eSpark-Backup/shuran-biotrackingdevice-hw/docs/Client-Files/PRD/Components list V1.2 05102024.xlsx

No. | Item | Part number/Model | Manufacturer | Note
1 | MCU | NRF5340-QKAA-R | Nordic
2 | LTE | SIM7500A | SIMCOM | North America region
3 | Bio tracking | MAX86176ENX+T | Maxim
 |  | MAX32666GXMBT+
 |  | MAX32674CGWGZ+
4 | LTE Antenna | IPEX Wired Antenna |  | define later
5 | GNSS Antenna | IPEX Wired Antenna |  | define later
6 | BLE Antenna | ANT3216LL00R2400A | Pulse Electronics
7 | Motion tracking | BMI270 | Bosch
8 | Microphone | ICS-40618 | TDK InvenSense | MEMS MIC
9 | Audio Codec | NAU8810YG | Nuvoton Tech | can replace due to space constraint
10 | Skin temperature sensor | AS6221-AWLT-S | AMS-OSRAM AG
11 | Speaker |  |  | define later
12 | Battery monitor | MAX17048G+T10 or LC709204FXE-01TBG | Analog Devices Inc./Maxim Integrated | can replace due to space constraint
13 | Battery charger | BQ24074RGTR | Texas Instruments
14 | Boost to 5V for PD LED | TPS61256AYFFR or MAX17270ENE+T | Texas Instruments | can replace due to space constraint
15 | LDO 3.3V | TPS7A0233PDQNR or MAX17270ENE+T | Texas Instruments | can replace due to space constraint
16 | LDO 1.8V | TPS7A0218PDQNR or MAX17270ENE+T | Texas Instruments | can replace due to space constraint
17 | Boost to 4.3V for LTE | MT3608L | XI'AN Aerosemi Tech | can replace due to space constraint
18 | Loadswitch | TCK107AG,LF or SIP32458DB-T2-GE1 |  | define later for fit space constraint
19 | Button | PTS830GG140SMTRLFS | ITT C&K
20 | RGB LED | XL-1615RGBC-RF | XINGLIGHT
21 | Charing port | Spring-Loaded Magnetic Pogo pin | China | define later
22 | Battery | 30x35x8mm 800mAh | China | can replace due to space constraint
23 | SWD jig pad | Custom jig pad 1.27mm pitch | N/A
