eSpark-Backup/shuran-biotrackingdevice-hw/Design-Files/Bio-Tracking-Device/Schematic/Bio-Tracking-Device.pdf

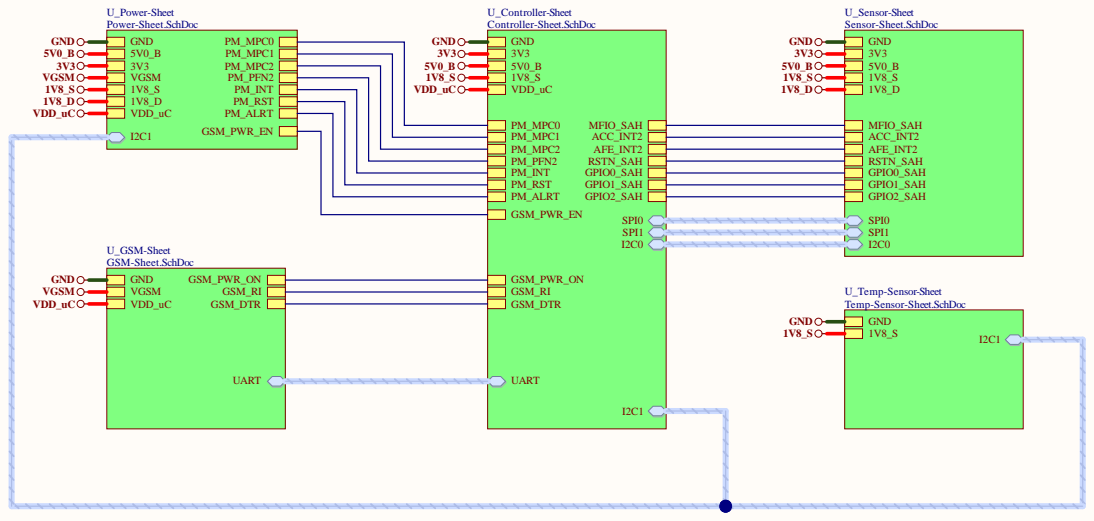
[picture p8: page 1]

Bio-Tracking-Device.PrjPcb

Date: 12/10/2024 | Page Num: 1

Drawn By: Huzaifa Ali | Page Total:

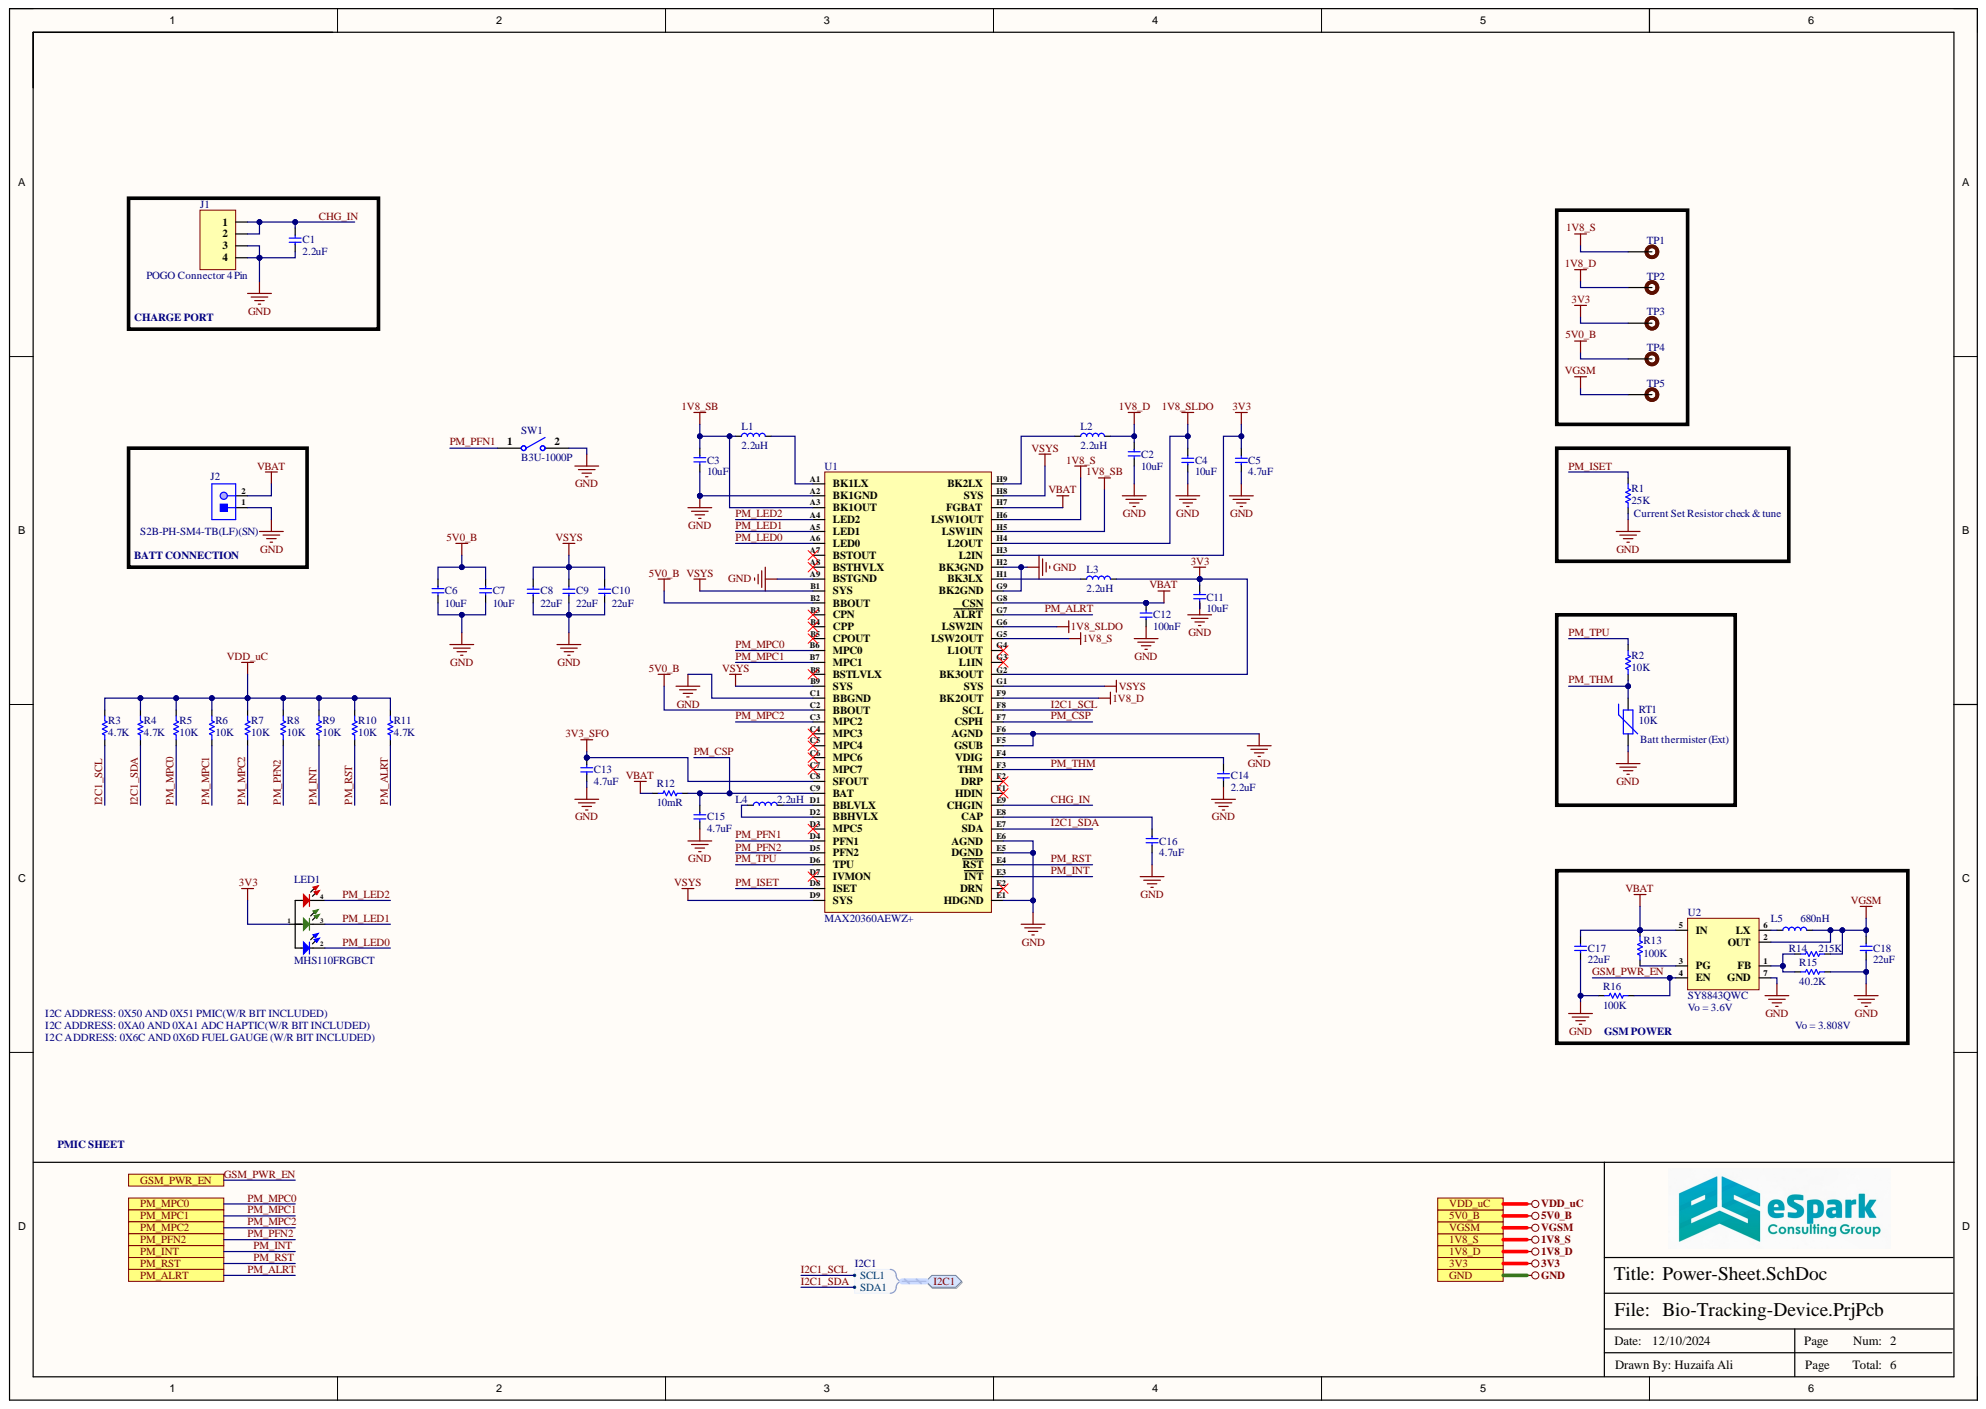
[picture p9: page 2]

VSYS | 2.2uH

C13 VBAT | MPC7 C7

BAT C9

I2C ADDRESS: 0X50 AND 0X51 PMIC(W/R BIT INCLUDED)
I2C ADDRESS: 0XA0 AND 0XA1 ADC HAPTIC(W/R BIT INCLUDED)
I2C ADDRESS: 0X6C AND 0X6D FUEL GAUGE (W/R BIT INCLUDED)

Bio-Tracking-Device.PrjPcb

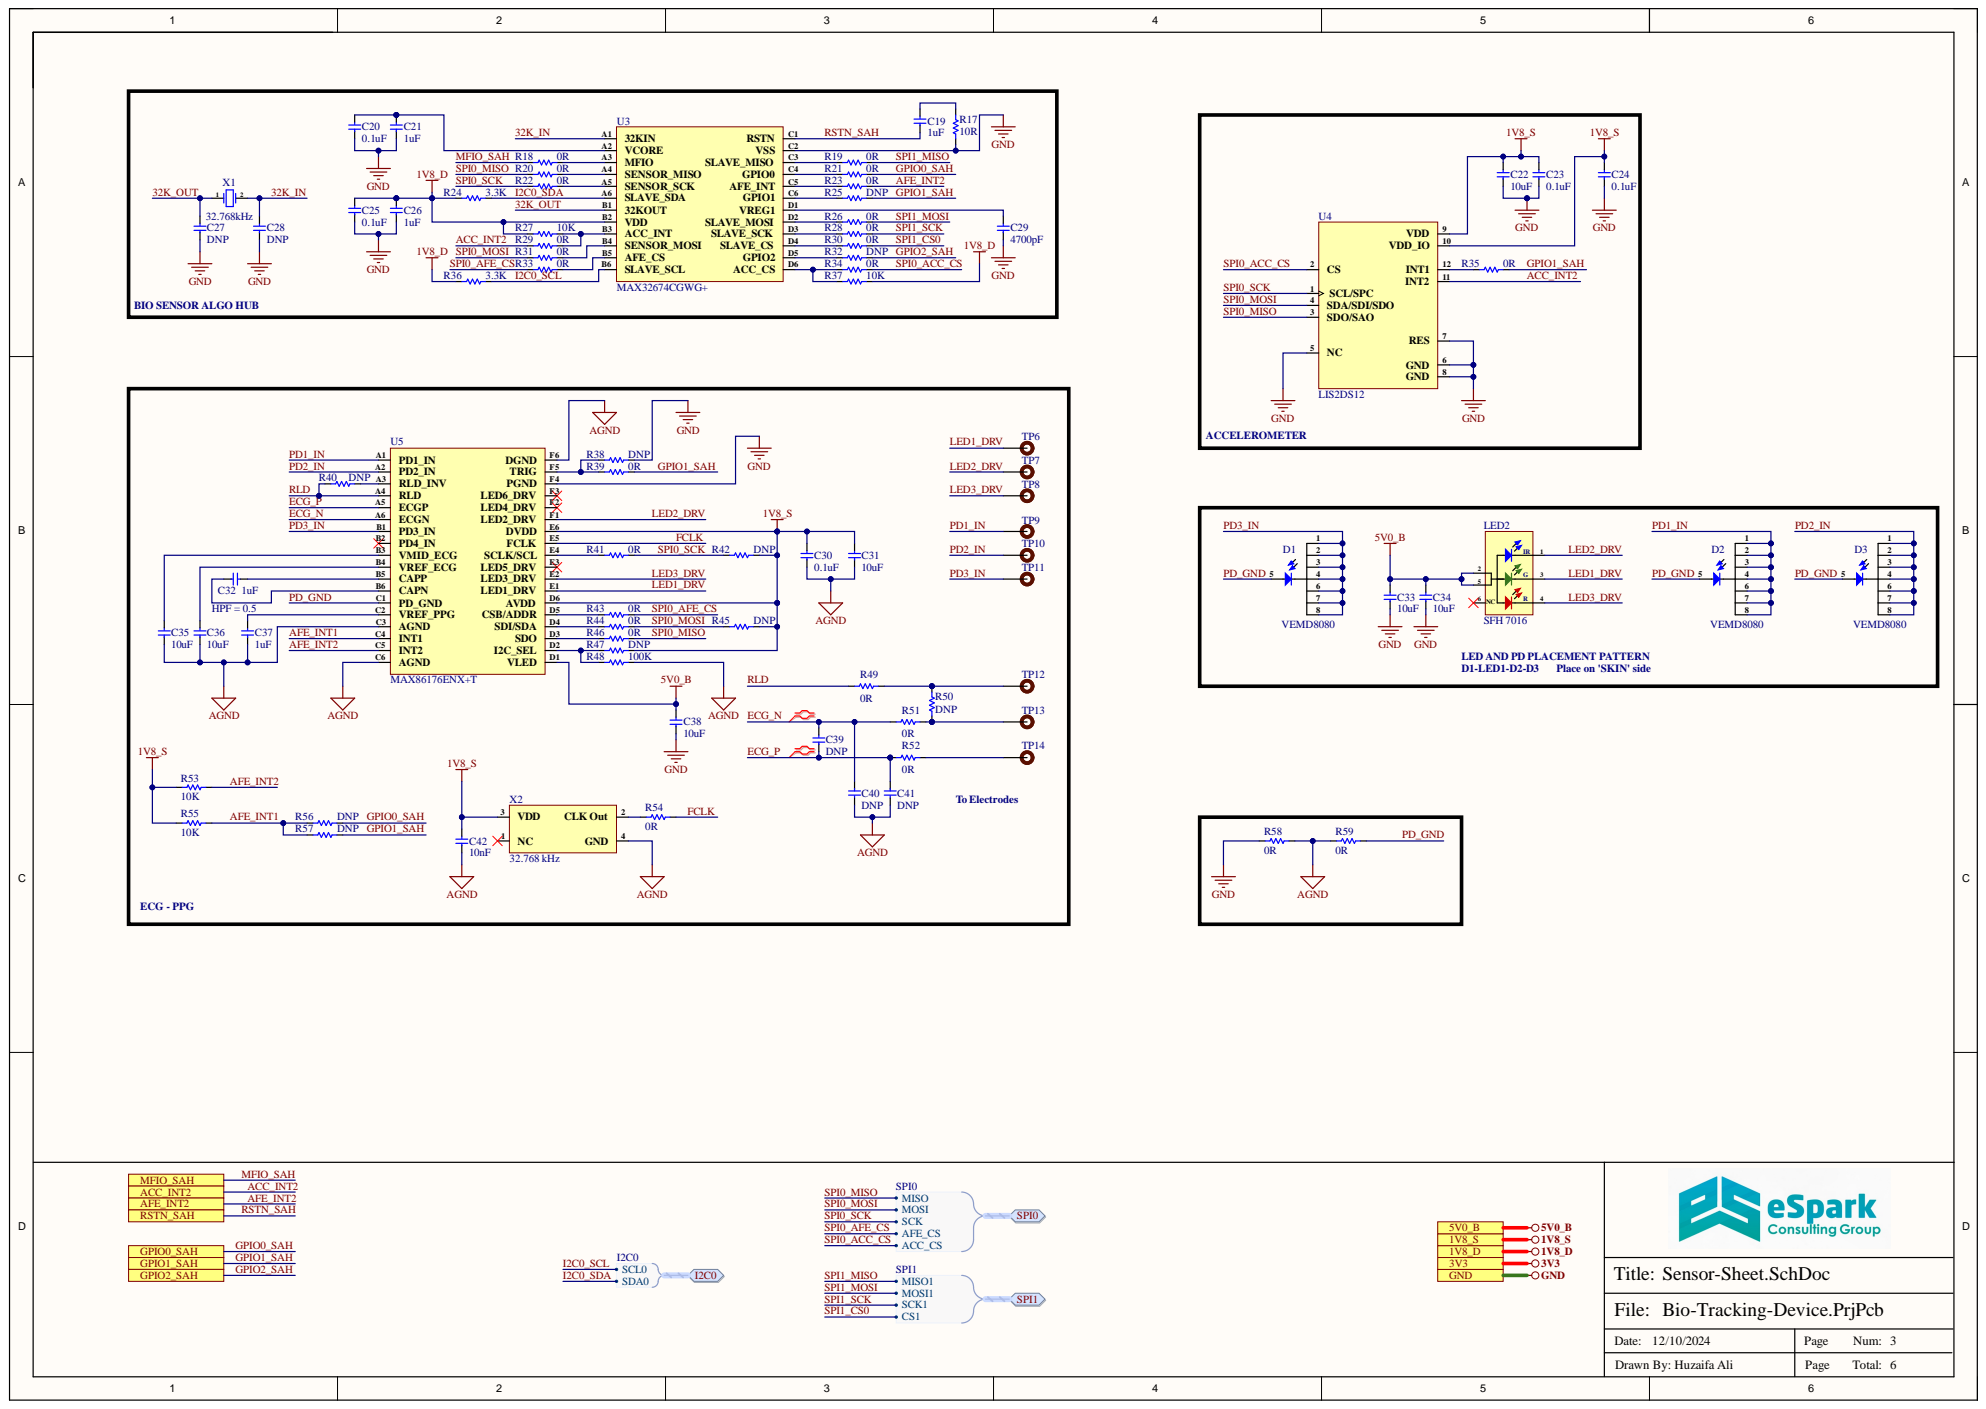
[picture p10: page 3]

BIO SENSOR ALGO HUB

R48 | 100K ECG_N

LED AND PD PLACEMENT PATTERN
D1-LED1-D2-D3

Place on 'SKIN' side

Bio-Tracking-Device.PrjPcb

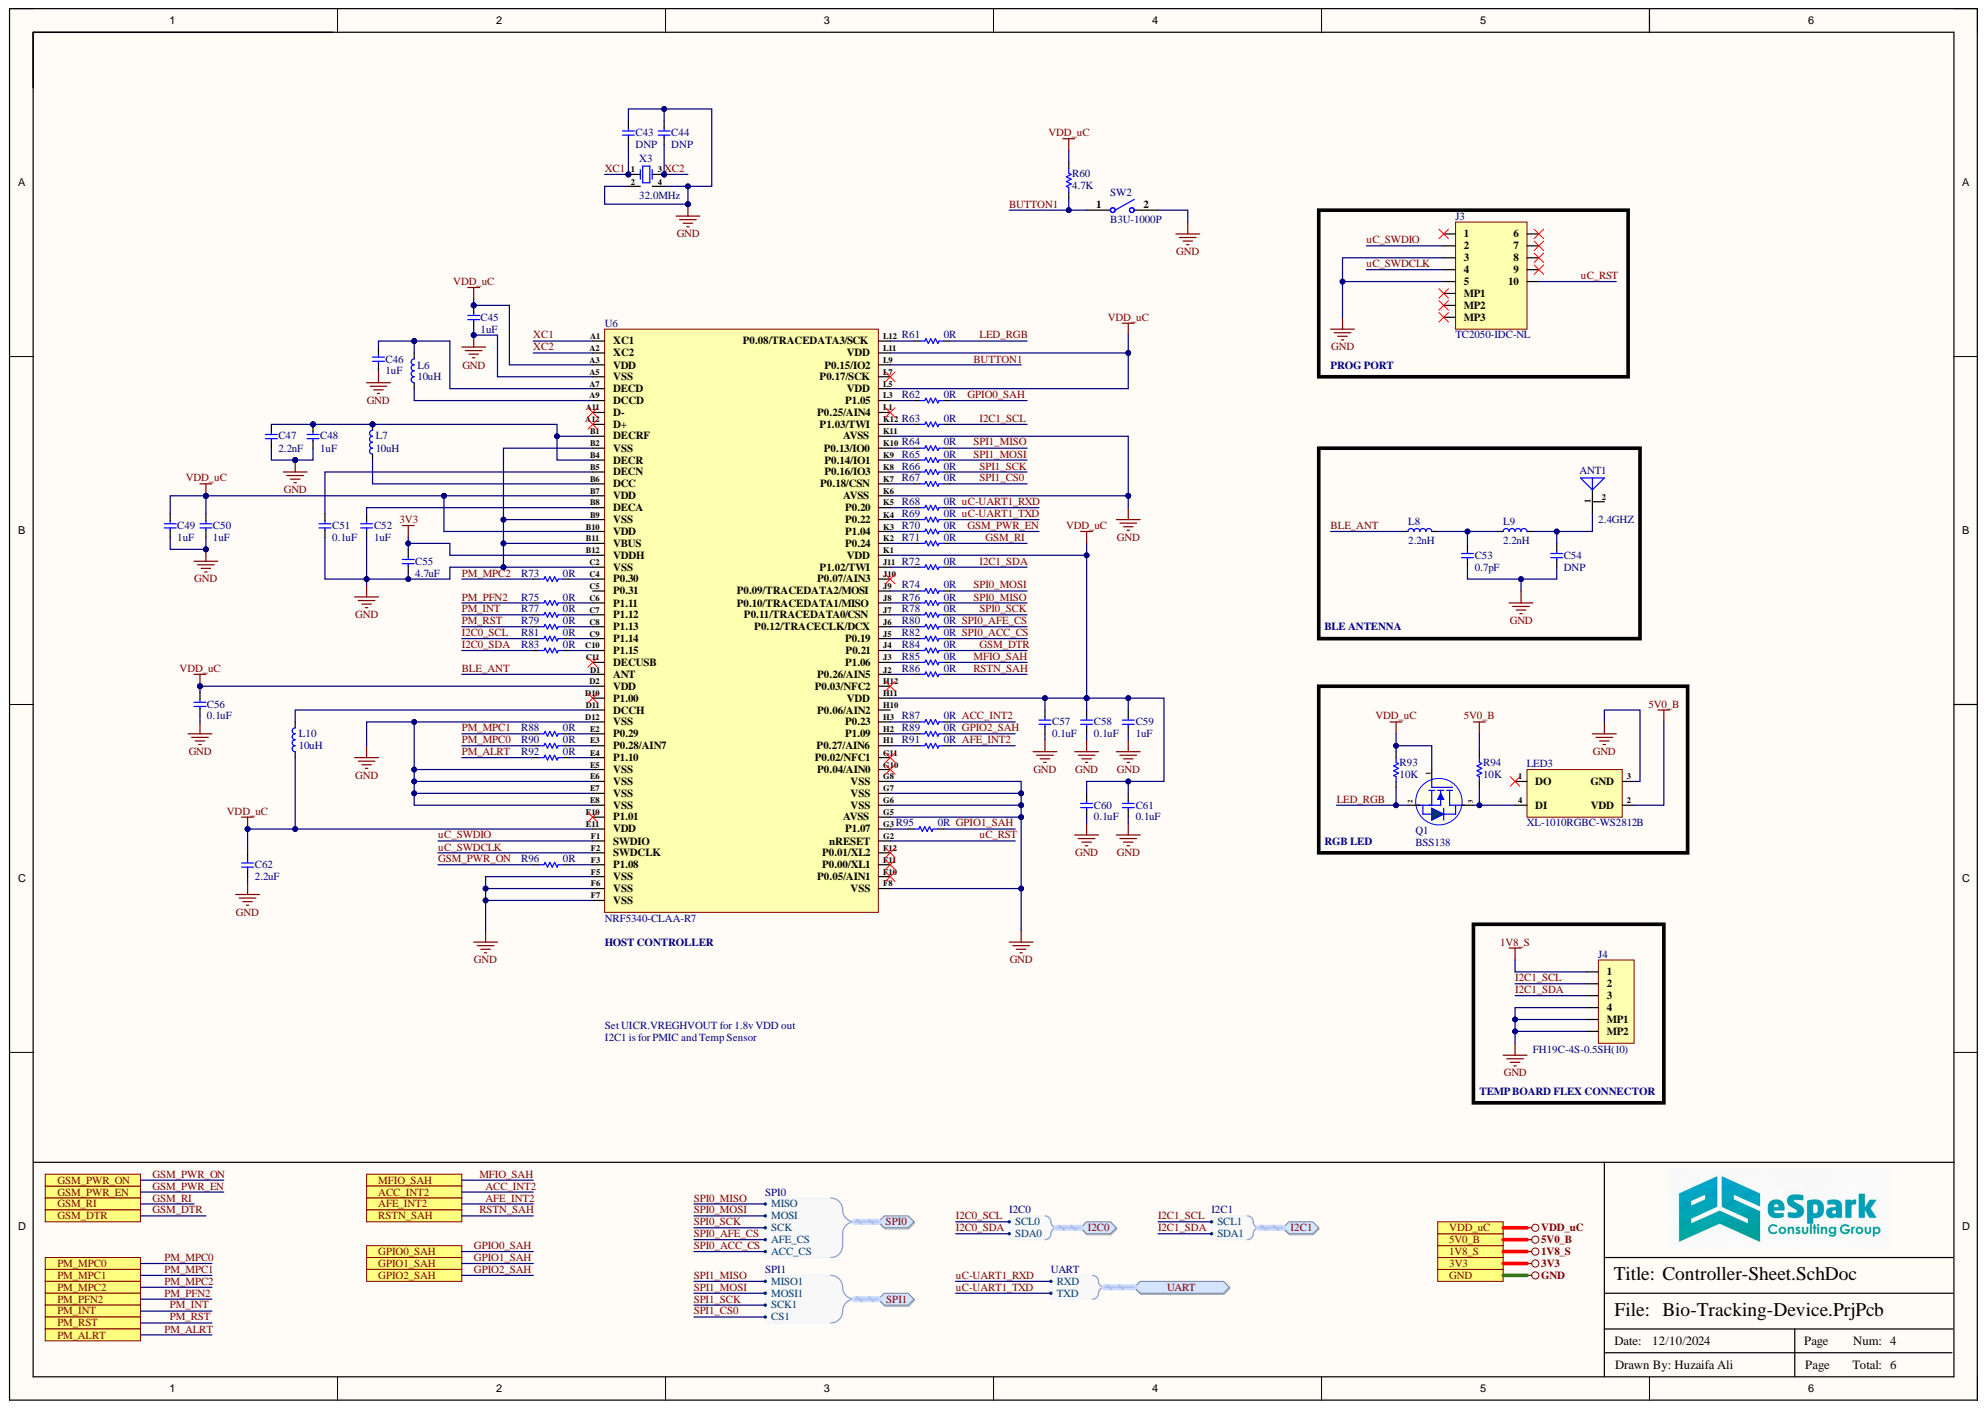
[picture p11: page 4]

Set UICR.VREGHVOUT for 1.8v VDD out
I2C1 is for PMIC and Temp Sensor

Bio-Tracking-Device.PrjPcb

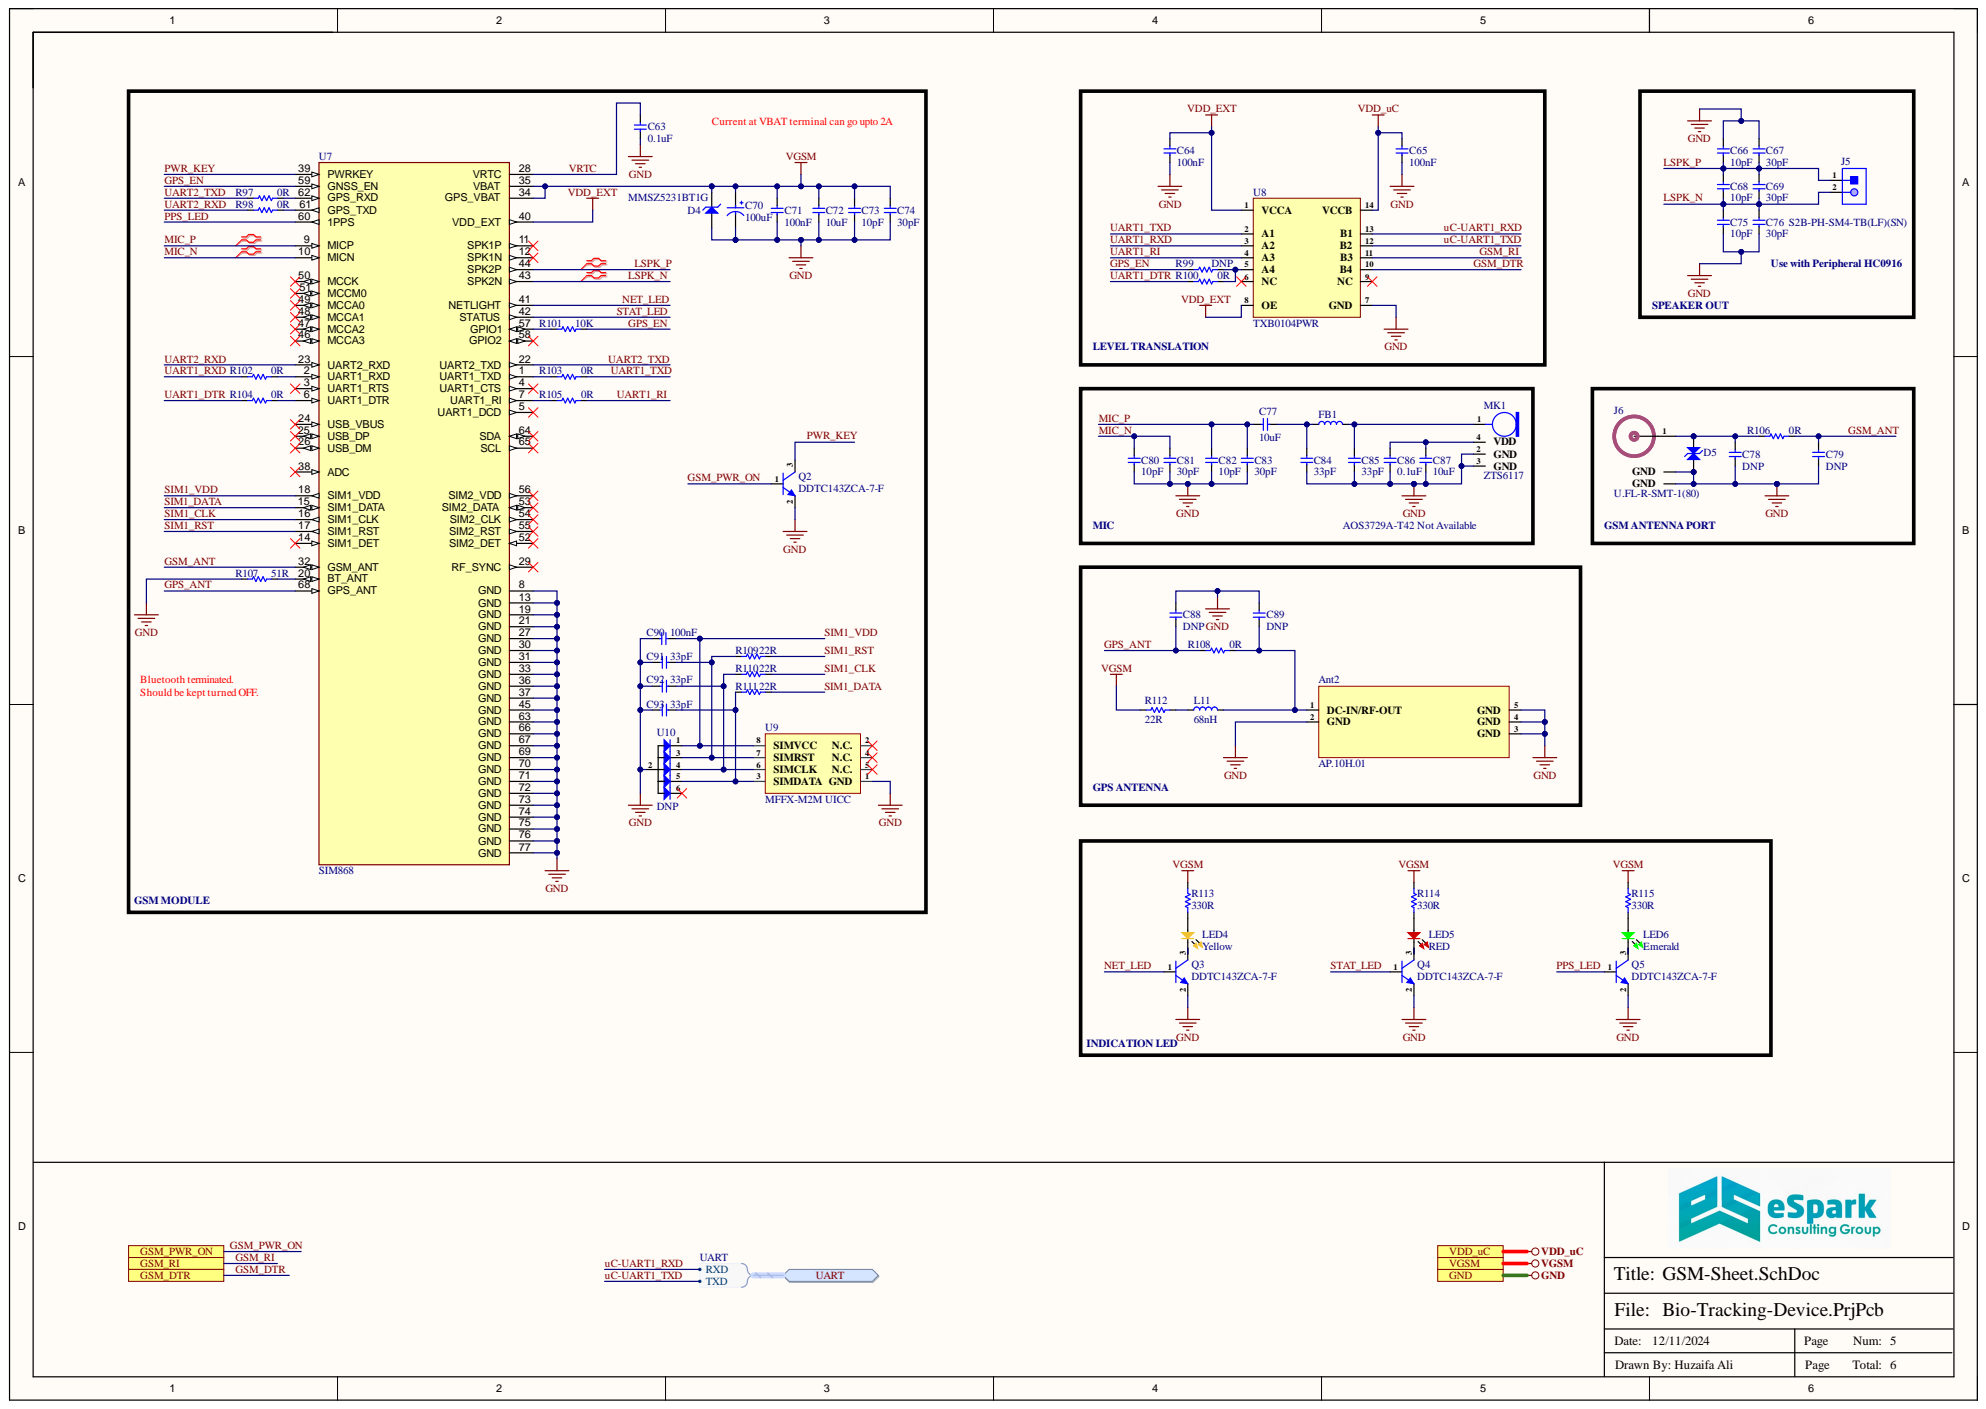
[picture p12: page 5]

Current at VBAT terminal can go upto 2A

Bluetooth terminated.
Should be kept turned OFF.

DC-IN/RF-OUT 1
GND 2

Bio-Tracking-Device.PrjPcb


Mounting should be done for efficient body contact

For Pinout Ref. only GND

This sheet will be created on Flex PCB

I2C ADDRESS: 0XA2 AND 0XA3 (W/RBIT INCLUDED)

Temp-Sensor-Sheet.SchDoc

Bio-Tracking-Device.PrjPcb

Date: 12/10/2024 | Page Num: 6

Drawn By: Huzaifa Ali | Page Total: 6
