eSpark-Backup/shuran-biotrackingdevice-hw/(list of files, drawings)

Other design files:
Design-Files/Bio-Tracking-Device/Bio-Tracking-Device.PrjPcb
Design-Files/Bio-Tracking-Device/Controller-Sheet.SchDoc
Design-Files/Bio-Tracking-Device/GSM-Sheet.SchDoc
Design-Files/Bio-Tracking-Device/Library-Files/PcbLib1.PcbLib
Design-Files/Bio-Tracking-Device/Library-Files/Schlib1.SchLib
Design-Files/Bio-Tracking-Device/PCB1.PcbDoc
Design-Files/Bio-Tracking-Device/Power-Sheet.SchDoc
Design-Files/Bio-Tracking-Device/Sensor-Sheet.SchDoc
Design-Files/Bio-Tracking-Device/Temp-Sensor-Sheet.SchDoc
Design-Files/Bio-Tracking-Device/Top-Sheet.SchDoc
