eSpark-Backup/shuran-biotrackingdevice-hw/(commit log)

2024-10-28 gitignore and PRD added
    [Components list V1.2 05102024.xlsx]
2024-11-05 #2 Dummy schematic file with some library that was created, pushed...
    [Bio-Tracking-Device.PrjPcb, PCB1.PcbDoc, PcbLib1.PcbLib, Power-Sheet.SchDoc, Schlib1.SchLib]
2024-11-07 #2 Added Power-Sheet, In progress
    [Bio-Tracking-Device.PrjPcb, Controller-Sheet.SchDoc, Power-Sheet.SchDoc]
2024-11-08 #2 Controller-Sheet Updated
    [Controller-Sheet.SchDoc]
2024-11-26 #2 Power-Sheet In Progress
    [Bio-Tracking-Device.PrjPcb, Controller-Sheet.SchDoc, Power-Sheet.SchDoc, Sensor-Sheet.SchDoc]
2024-11-29 #2 In Progress
    [Controller-Sheet.SchDoc, Power-Sheet.SchDoc, Sensor-Sheet.SchDoc]
2024-12-03 #2 Controller-Sheet in Progress
    [Controller-Sheet.SchDoc, Power-Sheet.SchDoc, Sensor-Sheet.SchDoc]
2024-12-10 #2 All Files Updated
    [Bio-Tracking-Device.PrjPcb, Controller-Sheet.SchDoc, GSM-Sheet.SchDoc, Power-Sheet.SchDoc, Sensor-Sheet.SchDoc, Temp-Sensor-Sheet.SchDoc, Top-Sheet.SchDoc]
2024-12-11 #2 PDF Created
    [GSM-Sheet.SchDoc]
2024-12-11 #2 Minor updates
    [Controller-Sheet.SchDoc, GSM-Sheet.SchDoc, Power-Sheet.SchDoc, Sensor-Sheet.SchDoc, Top-Sheet.SchDoc]
